k-anderson/irrigation-wireless-relay/rx/rx-back.png

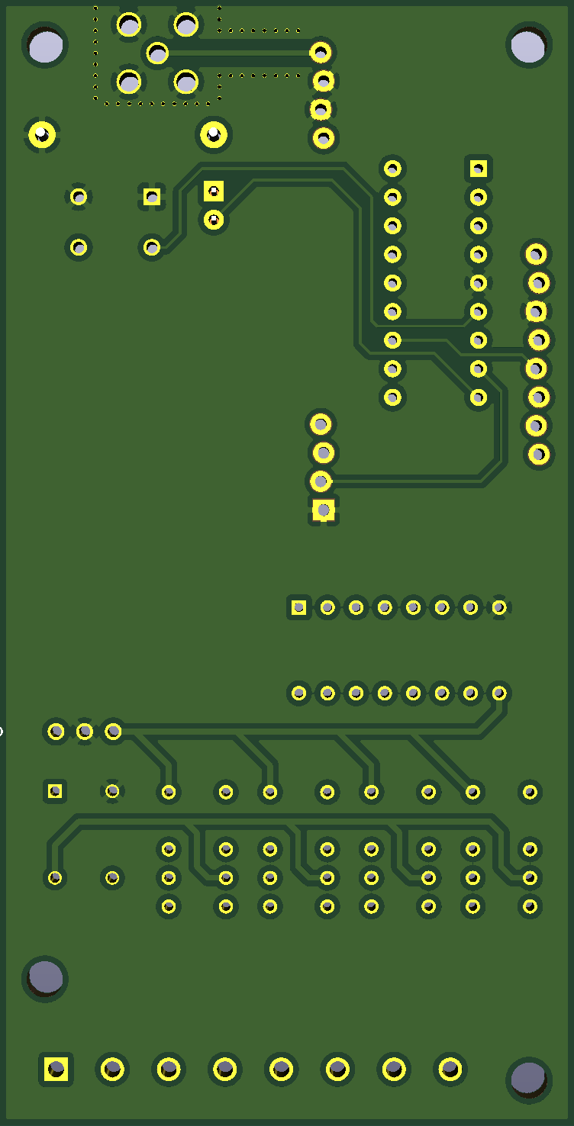
rx/rx-back.png
