k-anderson/irrigation-wireless-relay/rx/rx-front.png

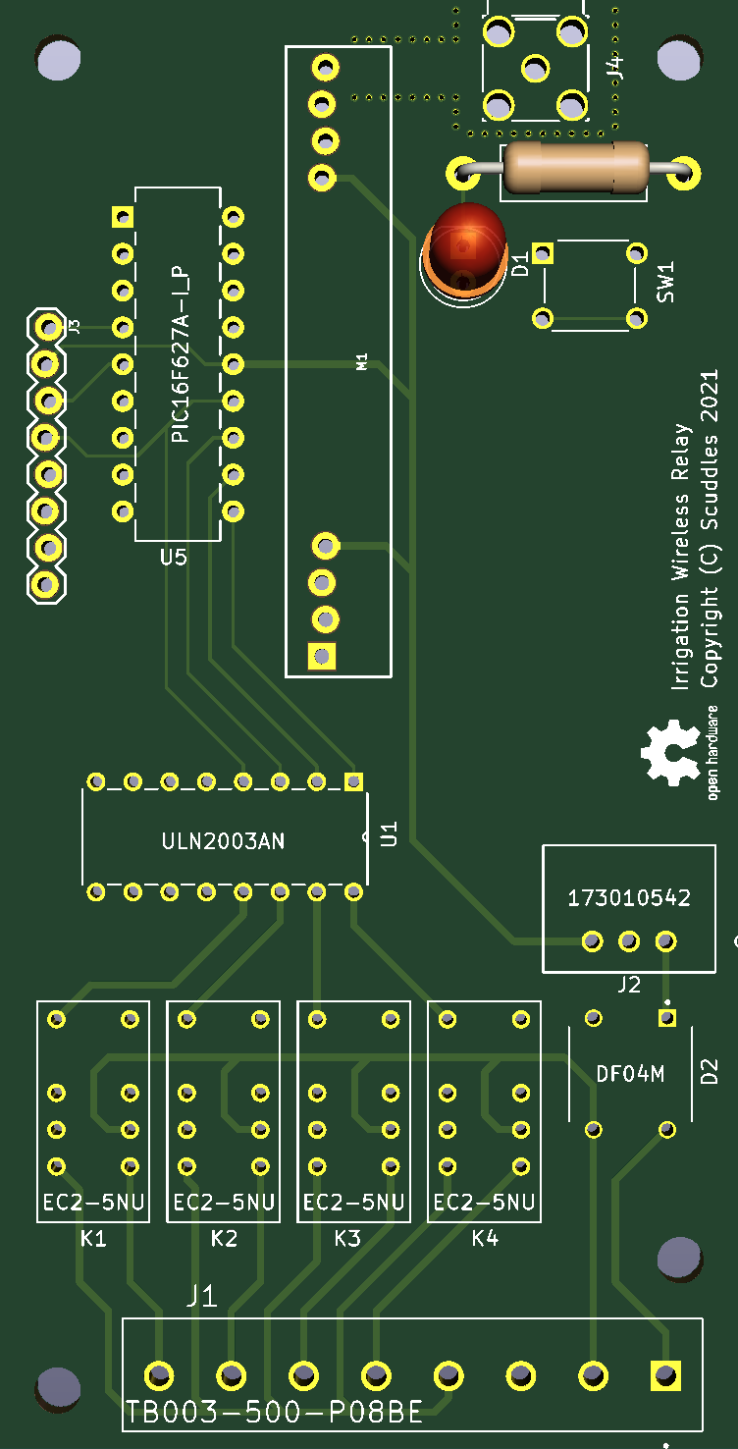
rx/rx-front.png
