k-anderson/irrigation-wireless-relay/rx/rx-prototype.jpg

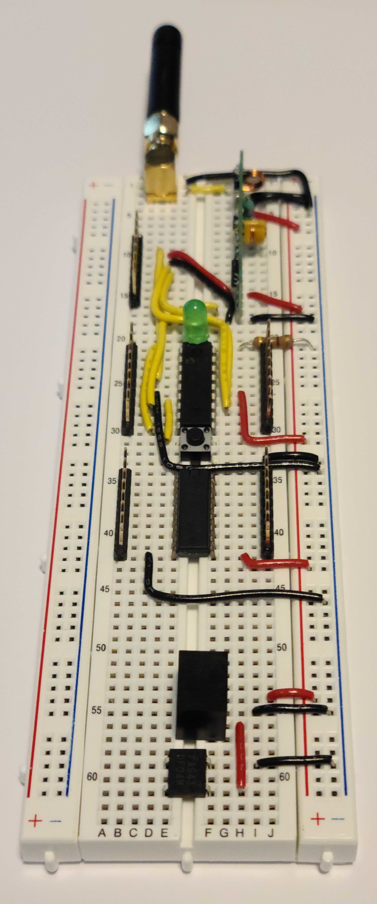
rx/rx-prototype.jpg
