k-anderson/irrigation-wireless-relay/tx/tx-back.png

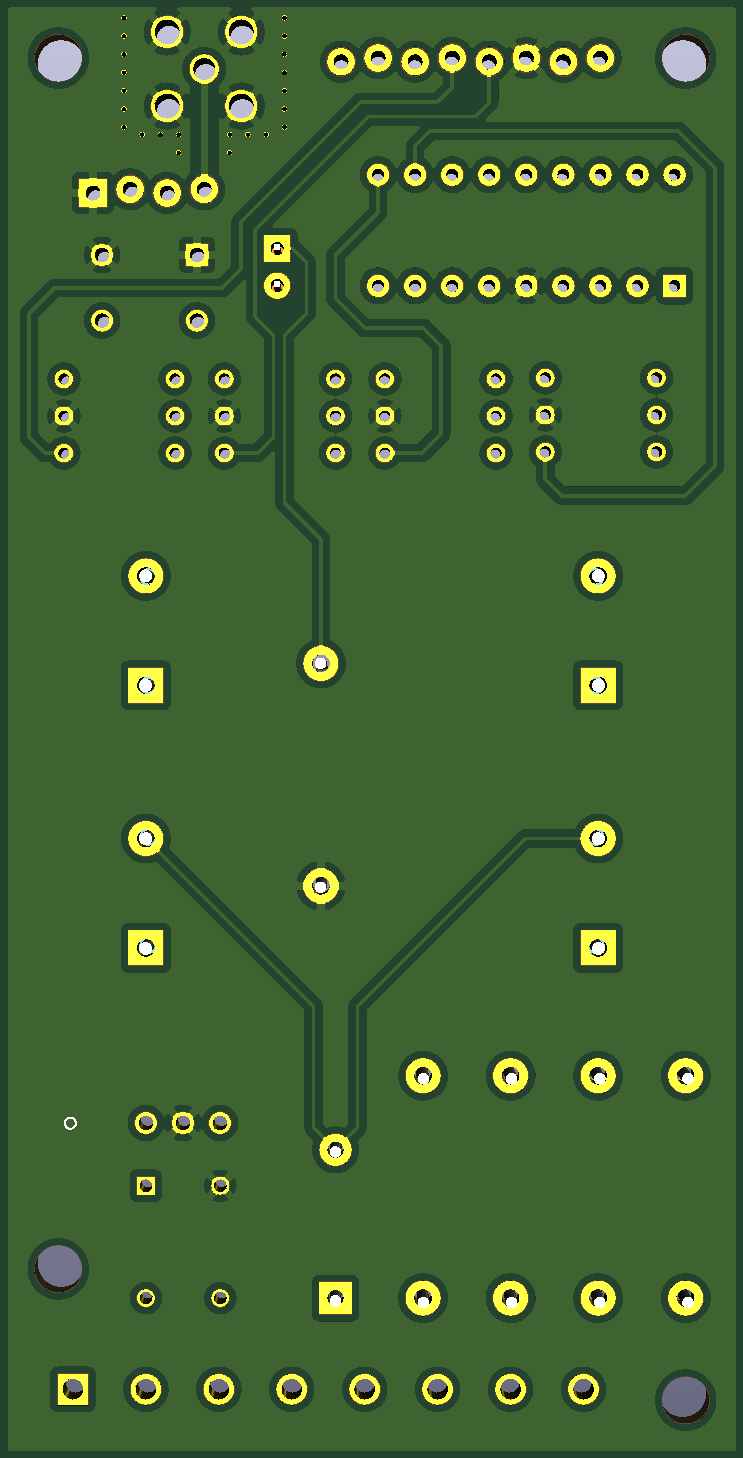
tx/tx-back.png
