k-anderson/irrigation-wireless-relay/tx/tx-front.png

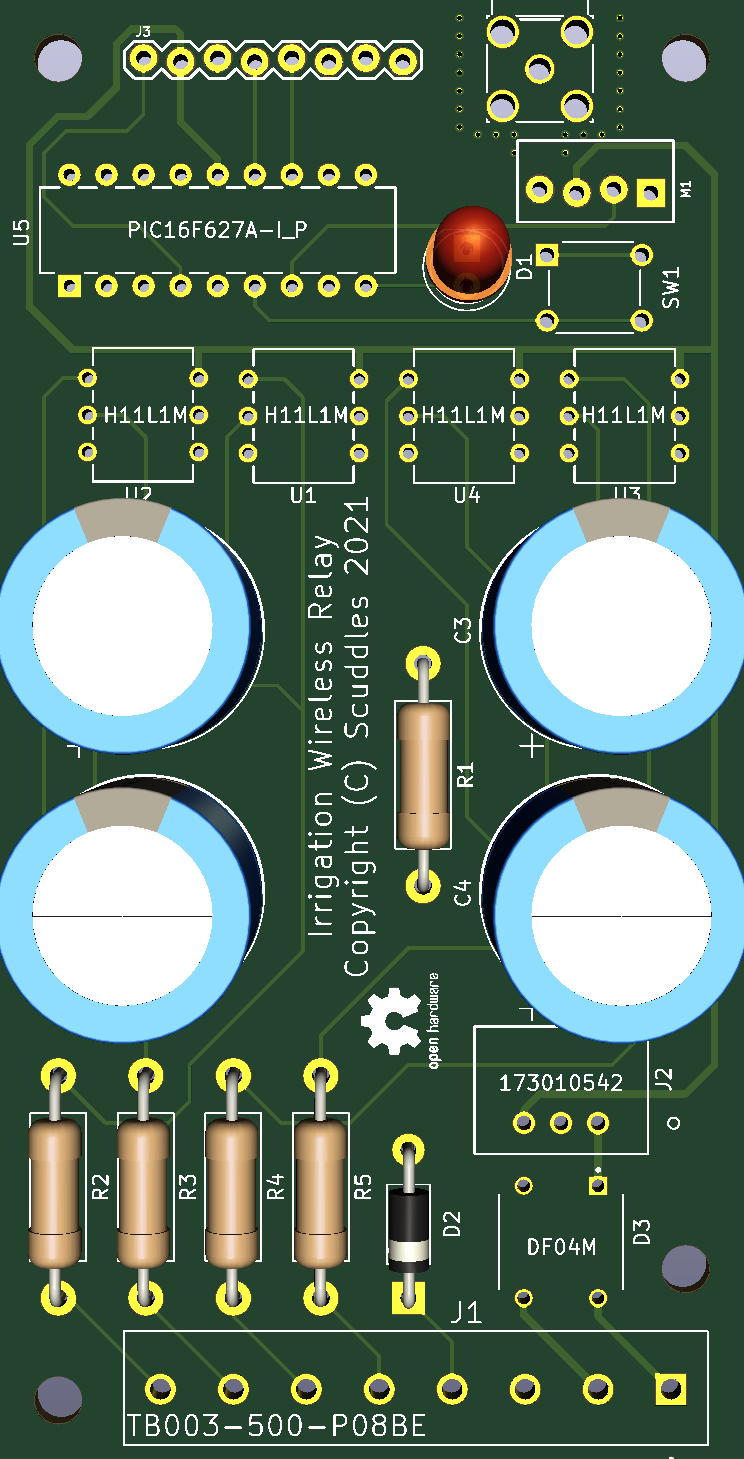
tx/tx-front.png
