k-anderson/irrigation-wireless-relay/tx/tx-prototype.jpg

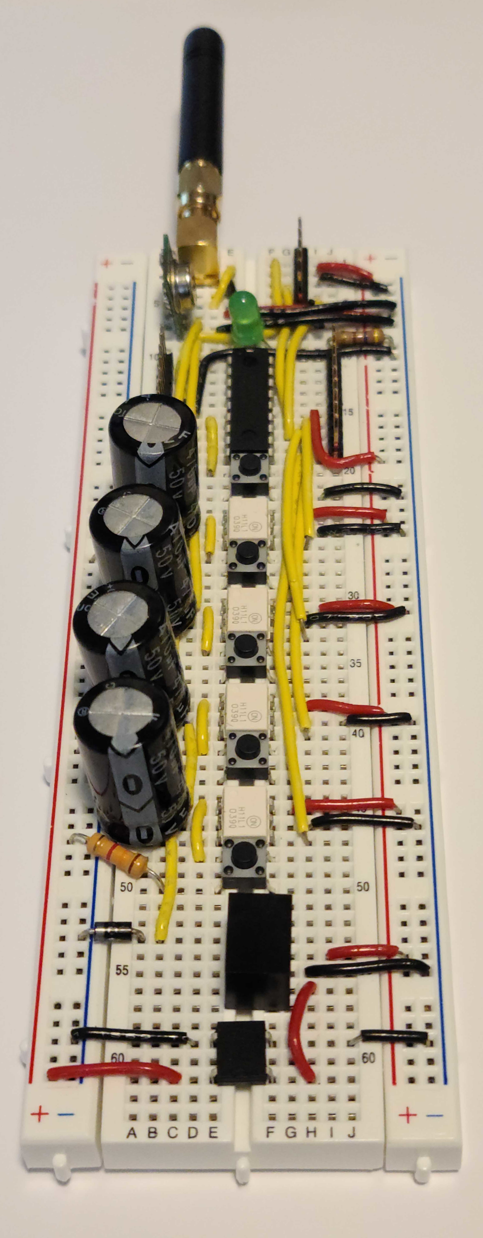
tx/tx-prototype.jpg
