k-anderson/irrigation-wireless-relay/tx/kicad/tx.kicad_pcb

## KiCad design tx/kicad/tx.kicad_pcb (2021-01-27)

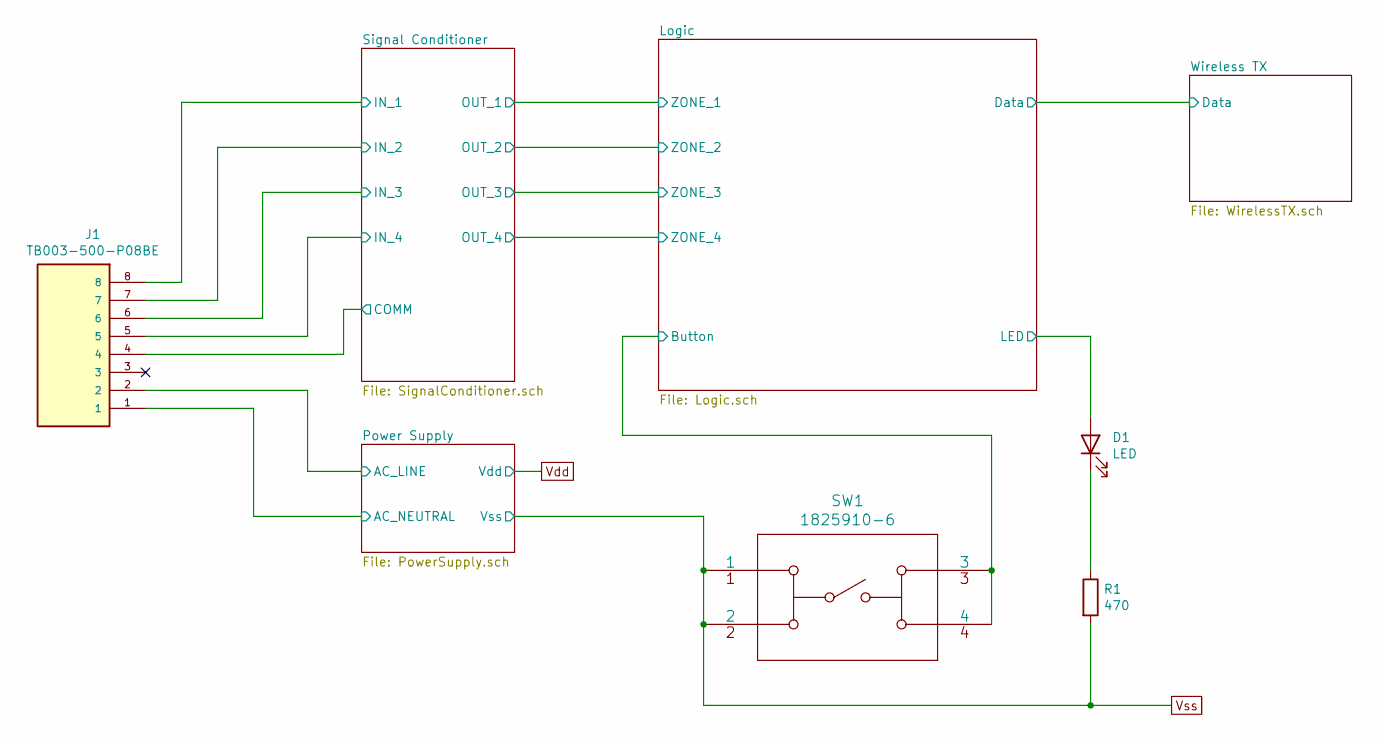
[picture p11: schematic tx.sch]

Parts:
D1: LED; LED_D5.0mm
J1: TB003-500-P08BE; CUI_TB003-500-P08BE
R1: 470; R_Axial_DIN0411_L9.9mm_D3.6mm_P15.24mm_Horizontal
SW1: 1825910-6; Digi-Key_PN 450-1650-ND

Connections:
/Logic/Button: SW1.3, SW1.4; also elsewhere on the board
/Logic/LED: D1.2 (A); also elsewhere on the board
/Power Supply/AC_LINE: J1.2; also elsewhere on the board
/Power Supply/AC_NEUTRAL: J1.1; also elsewhere on the board
/Signal Conditioner/COMM: J1.4; also elsewhere on the board
/Signal Conditioner/IN_1: J1.8; also elsewhere on the board
/Signal Conditioner/IN_2: J1.7; also elsewhere on the board
/Signal Conditioner/IN_3: J1.6; also elsewhere on the board
/Signal Conditioner/IN_4: J1.5; also elsewhere on the board
unnamed: D1.1 (K), R1.1
Vss: R1.2, SW1.1, SW1.2; also elsewhere on the board

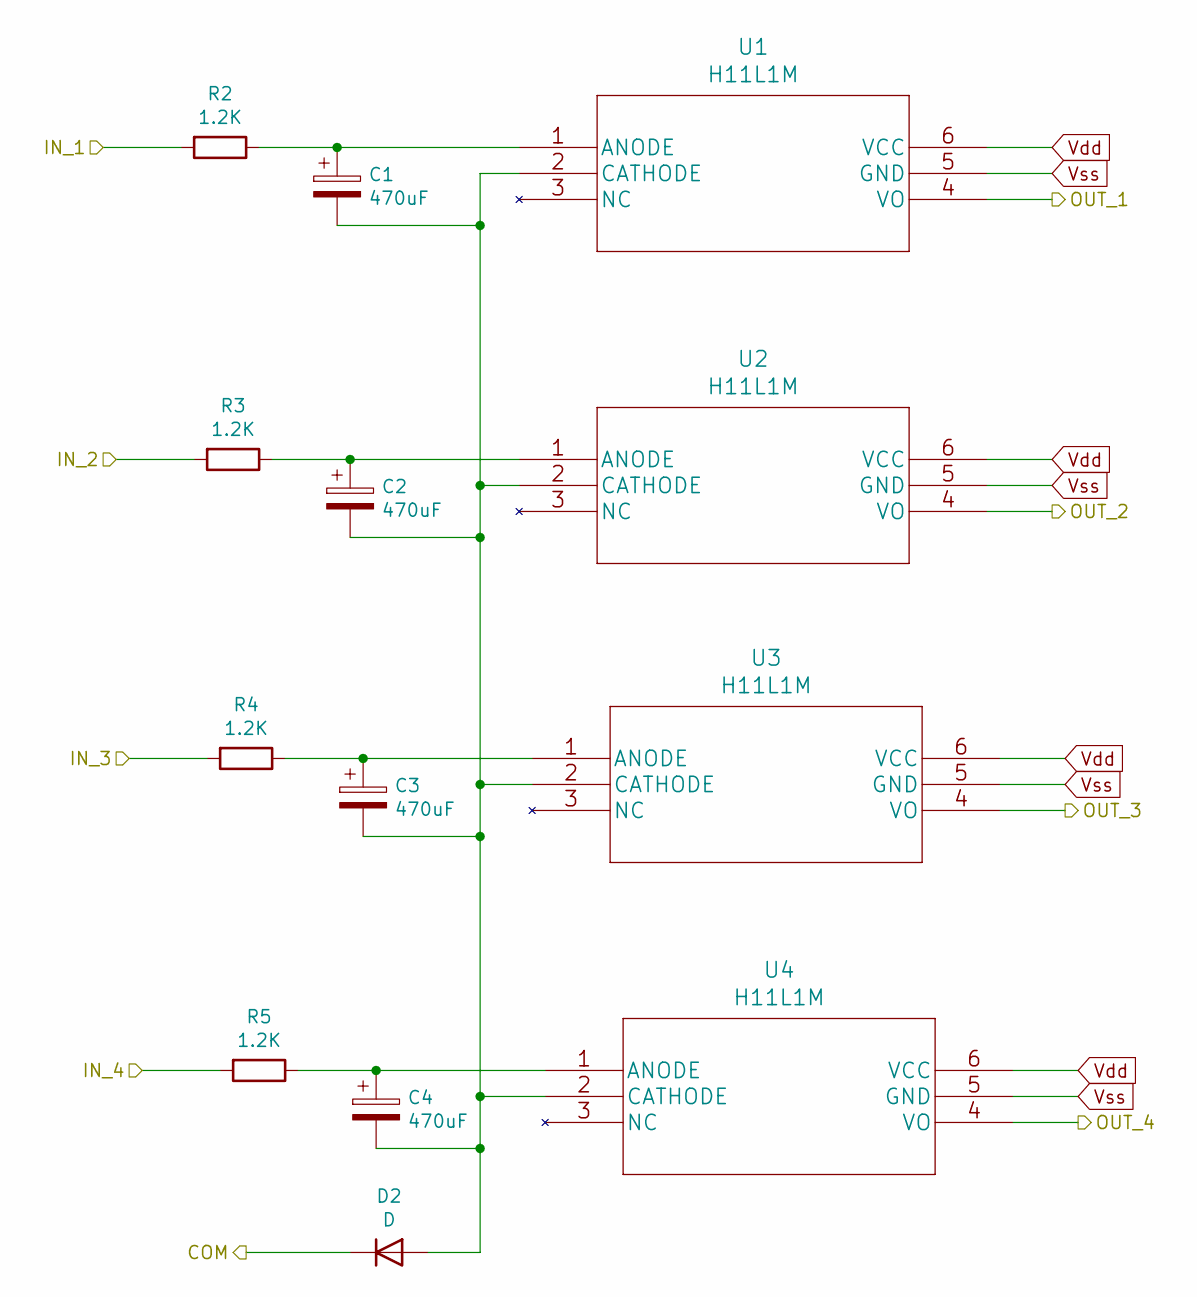
[picture p12: schematic SignalConditioner.sch]

Parts:
C1, C2, C3, C4: 470uF; CP_Radial_D16.0mm_P7.50mm
D2: D; D_DO-41_SOD81_P10.16mm_Horizontal
R2, R3, R4, R5: 1.2K; R_Axial_DIN0411_L9.9mm_D3.6mm_P15.24mm_Horizontal
U1, U2, U3, U4: H11L1M; Digi-Key_PN H11L1-MQT-ND

Connections:
/Signal Conditioner/COMM: D2.1 (K); also elsewhere on the board
/Signal Conditioner/IN_1: R2.2; also elsewhere on the board
/Signal Conditioner/IN_2: R3.2; also elsewhere on the board
/Signal Conditioner/IN_3: R4.2; also elsewhere on the board
/Signal Conditioner/IN_4: R5.2; also elsewhere on the board
/Signal Conditioner/OUT_1: U1.4 (VO); also elsewhere on the board
/Signal Conditioner/OUT_2: U2.4 (VO); also elsewhere on the board
/Signal Conditioner/OUT_3: U3.4 (VO); also elsewhere on the board
/Signal Conditioner/OUT_4: U4.4 (VO); also elsewhere on the board
unnamed: C1.1, R2.1, U1.1 (ANODE)
unnamed: C1.2, C2.2, C3.2, C4.2, D2.2 (A), U1.2 (CATHODE), U2.2 (CATHODE), U3.2 (CATHODE), U4.2 (CATHODE)
unnamed: C2.1, R3.1, U2.1 (ANODE)
unnamed: C3.1, R4.1, U3.1 (ANODE)
unnamed: C4.1, R5.1, U4.1 (ANODE)
Vdd: U1.6 (VCC), U2.6 (VCC), U3.6 (VCC), U4.6 (VCC); also elsewhere on the board
Vss: U1.5 (GND), U2.5 (GND), U3.5 (GND), U4.5 (GND); also elsewhere on the board

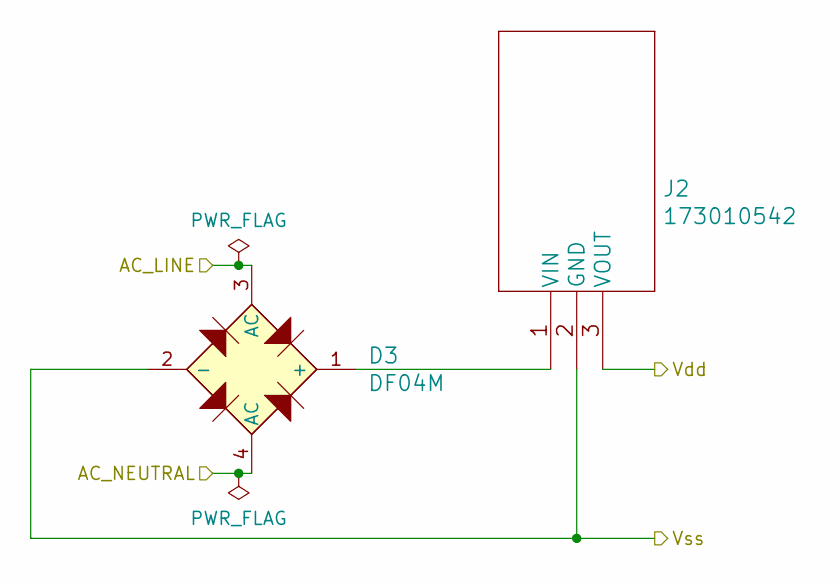
[picture p13: schematic PowerSupply.sch]

Parts:
D3: DF04M; Digi-Key_PN DF04M-ND
J2: 173010542; Digi-Key_PN 732-10874-ND

Connections:
/Power Supply/AC_LINE: D3.3 (AC); also elsewhere on the board
/Power Supply/AC_NEUTRAL: D3.4 (AC); also elsewhere on the board
unnamed: D3.1 (+), J2.1 (VIN)
Vdd: J2.3 (VOUT); also elsewhere on the board
Vss: D3.2 (-), J2.2 (GND); also elsewhere on the board

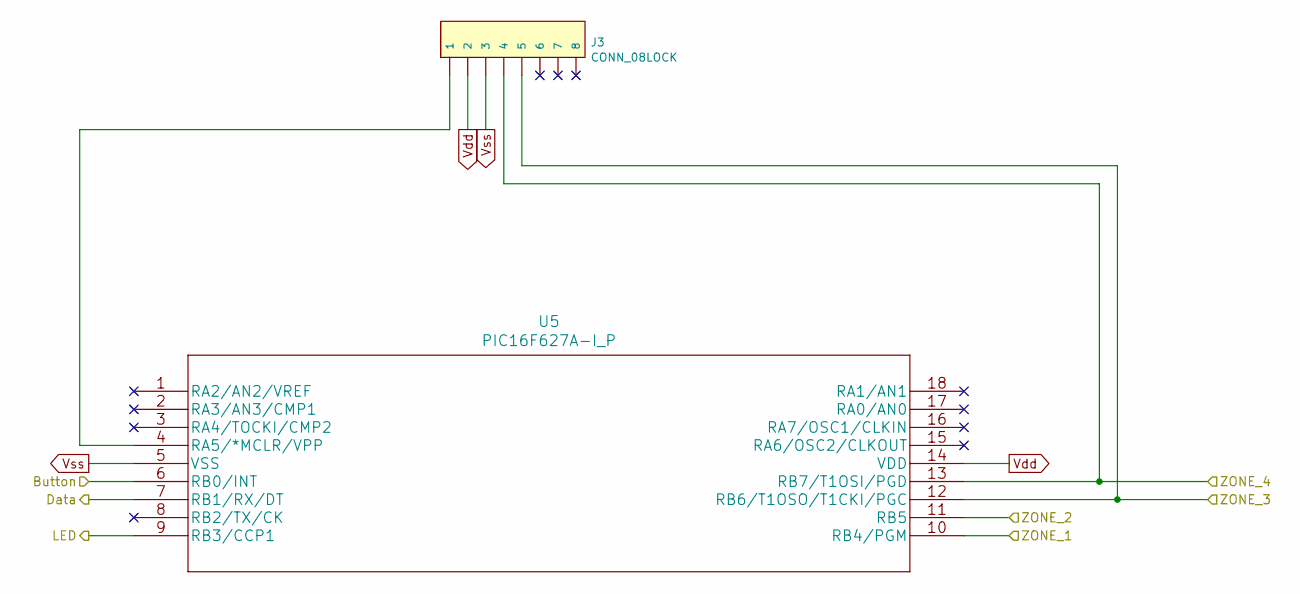
[picture p14: schematic Logic.sch]

Parts:
J3: CONN_08LOCK; 1X08_LOCK
U5: PIC16F627A-I_P; PIC16F627A-I&slash_P; Digi-Key_PN PIC16F627A-I/P-ND

Connections:
/Logic/Button: U5.6 (RB0/INT); also elsewhere on the board
/Logic/Data: U5.7 (RB1/RX/DT); also elsewhere on the board
/Logic/LED: U5.9 (RB3/CCP1); also elsewhere on the board
/Signal Conditioner/OUT_1: U5.10 (RB4/PGM); also elsewhere on the board
/Signal Conditioner/OUT_2: U5.11 (RB5); also elsewhere on the board
/Signal Conditioner/OUT_3: J3.5, U5.12 (RB6/T1OSO/T1CKI/PGC); also elsewhere on the board
/Signal Conditioner/OUT_4: J3.4, U5.13 (RB7/T1OSI/PGD); also elsewhere on the board
unnamed: J3.1, U5.4 (RA5/*MCLR/VPP)
Vdd: J3.2, U5.14 (VDD); also elsewhere on the board
Vss: J3.3, U5.5 (VSS); also elsewhere on the board

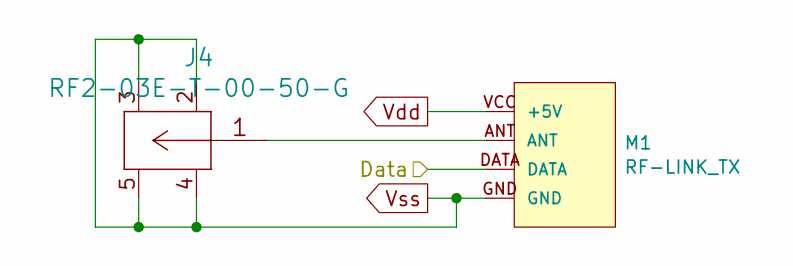
[picture p15: schematic WirelessTX.sch]

Parts:
J4: RF2-03E-T-00-50-G; Digi-Key_PN 2057-RF2-03E-T-00-50-G-ND
M1: RF-LINK_TX; WRL-10534; Digi-Key_PN 1568-1175-ND

Connections:
/Logic/Data: M1.DATA; also elsewhere on the board
unnamed: J4.1, M1.ANT
Vdd: M1.VCC (+5V); also elsewhere on the board
Vss: J4.2 (Shield), J4.3 (Shield), J4.4 (Shield), J4.5 (Shield), M1.GND; also elsewhere on the board

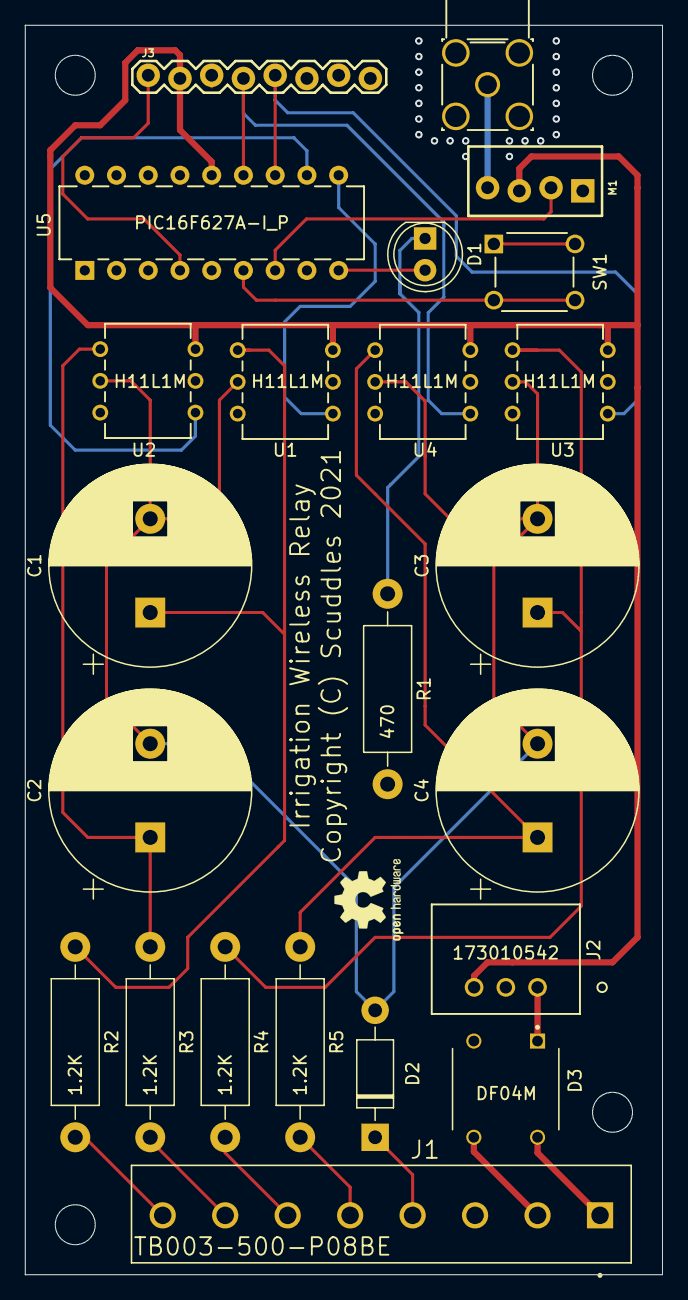
[picture p16: board tx.kicad_pcb from above]

Board: 2 copper layers, 51.0 x 100.0 mm, 23 parts (0 on the bottom side), 25 nets.
