k-anderson/irrigation-wireless-relay/rx/kicad/rx.kicad_pcb

## KiCad design rx/kicad/rx.kicad_pcb (2021-01-27)

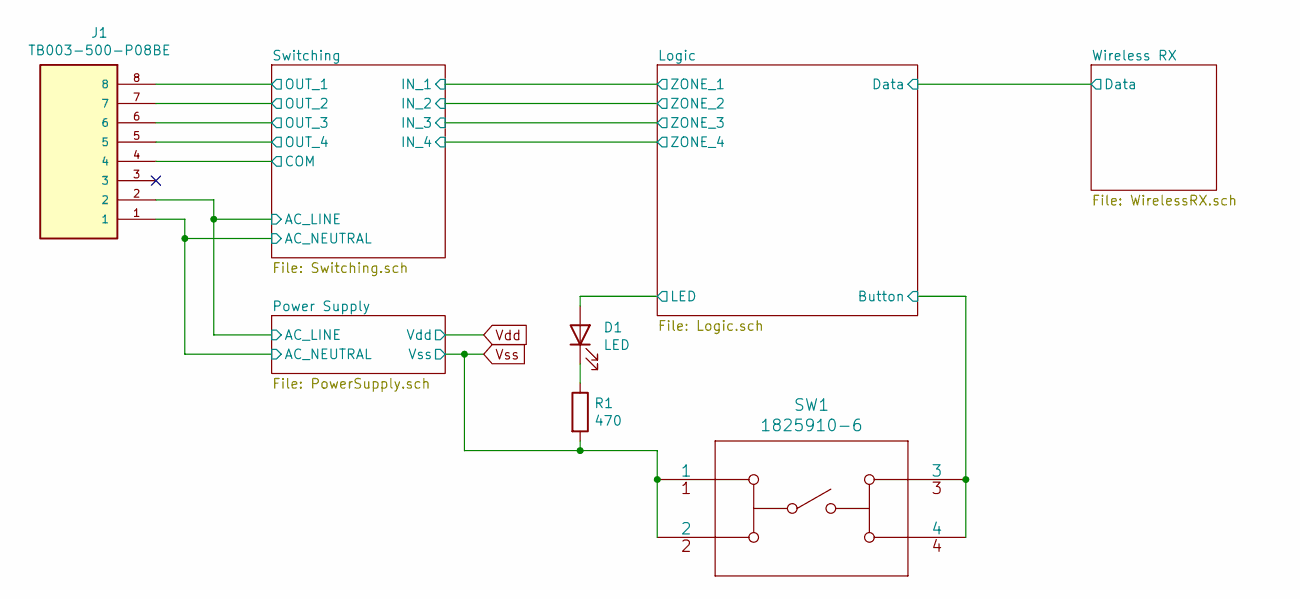
[picture p17: schematic rx.sch]

Parts:
D1: LED; LED_D5.0mm
J1: TB003-500-P08BE; CUI_TB003-500-P08BE
R1: 470; R_Axial_DIN0411_L9.9mm_D3.6mm_P15.24mm_Horizontal
SW1: 1825910-6

Connections:
/Logic/Button: SW1.3, SW1.4; also elsewhere on the board
/Logic/LED: D1.2 (A); also elsewhere on the board
/Power Supply/AC_LINE: J1.2; also elsewhere on the board
/Power Supply/AC_NEUTRAL: J1.1; also elsewhere on the board
/Switching/COM: J1.4; also elsewhere on the board
/Switching/OUT_1: J1.8; also elsewhere on the board
/Switching/OUT_2: J1.7; also elsewhere on the board
/Switching/OUT_3: J1.6; also elsewhere on the board
/Switching/OUT_4: J1.5; also elsewhere on the board
unnamed: D1.1 (K), R1.1
Vss: R1.2, SW1.1, SW1.2; also elsewhere on the board

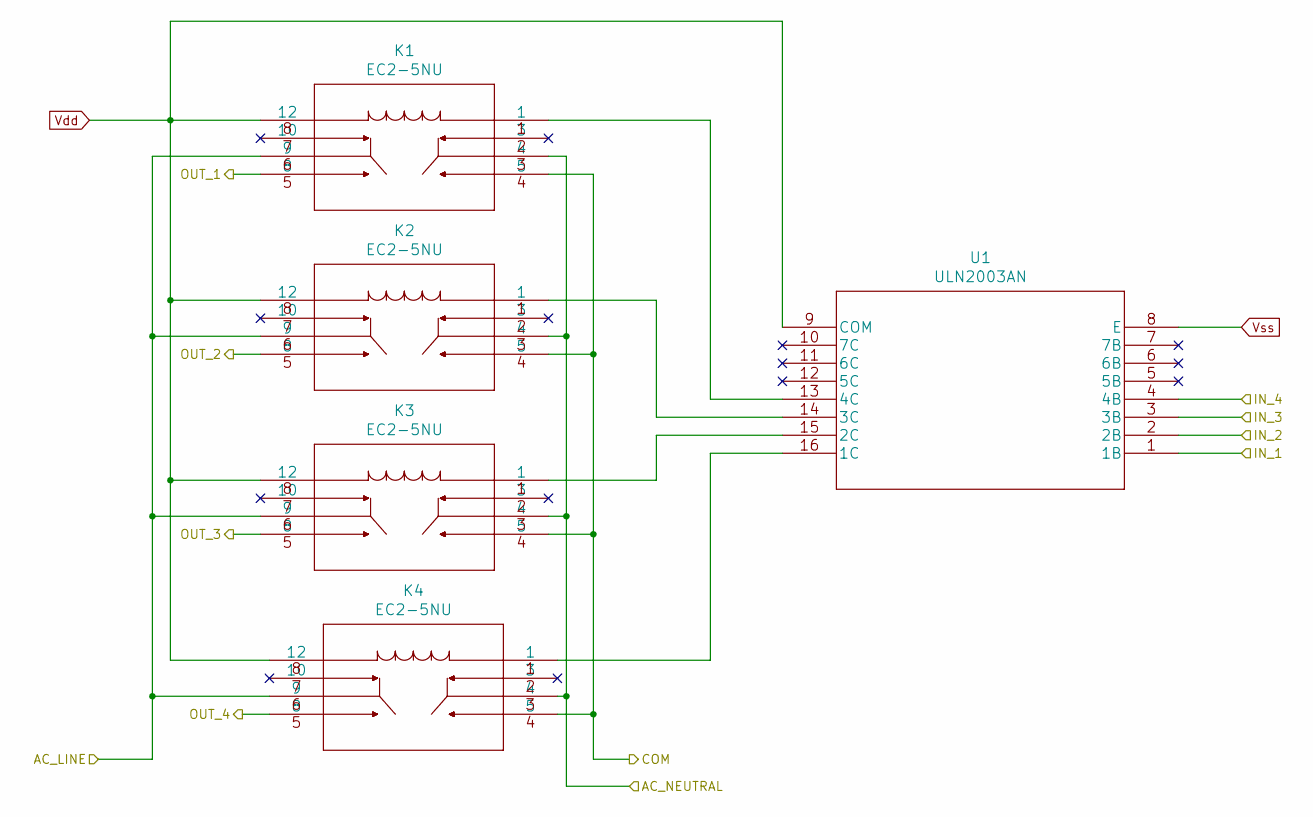
[picture p18: schematic Switching.sch]

Parts:
K1, K2, K3, K4: EC2-5NU
U1: ULN2003AN

Connections:
/Power Supply/AC_LINE: K1.6 (9), K2.6 (9), K3.6 (9), K4.6 (9); also elsewhere on the board
/Power Supply/AC_NEUTRAL: K1.3 (4), K2.3 (4), K3.3 (4), K4.3 (4); also elsewhere on the board
/Switching/COM: K1.4 (5), K2.4 (5), K3.4 (5), K4.4 (5); also elsewhere on the board
/Switching/IN_1: U1.1 (1B); also elsewhere on the board
/Switching/IN_2: U1.2 (2B); also elsewhere on the board
/Switching/IN_3: U1.3 (3B); also elsewhere on the board
/Switching/IN_4: U1.4 (4B); also elsewhere on the board
/Switching/OUT_1: K1.5 (8); also elsewhere on the board
/Switching/OUT_2: K2.5 (8); also elsewhere on the board
/Switching/OUT_3: K3.5 (8); also elsewhere on the board
/Switching/OUT_4: K4.5 (8); also elsewhere on the board
unnamed: K1.1, U1.13 (4C)
unnamed: K2.1, U1.14 (3C)
unnamed: K3.1, U1.15 (2C)
unnamed: K4.1, U1.16 (1C)
Vdd: K1.8 (12), K2.8 (12), K3.8 (12), K4.8 (12), U1.9 (COM); also elsewhere on the board
Vss: U1.8 (E); also elsewhere on the board

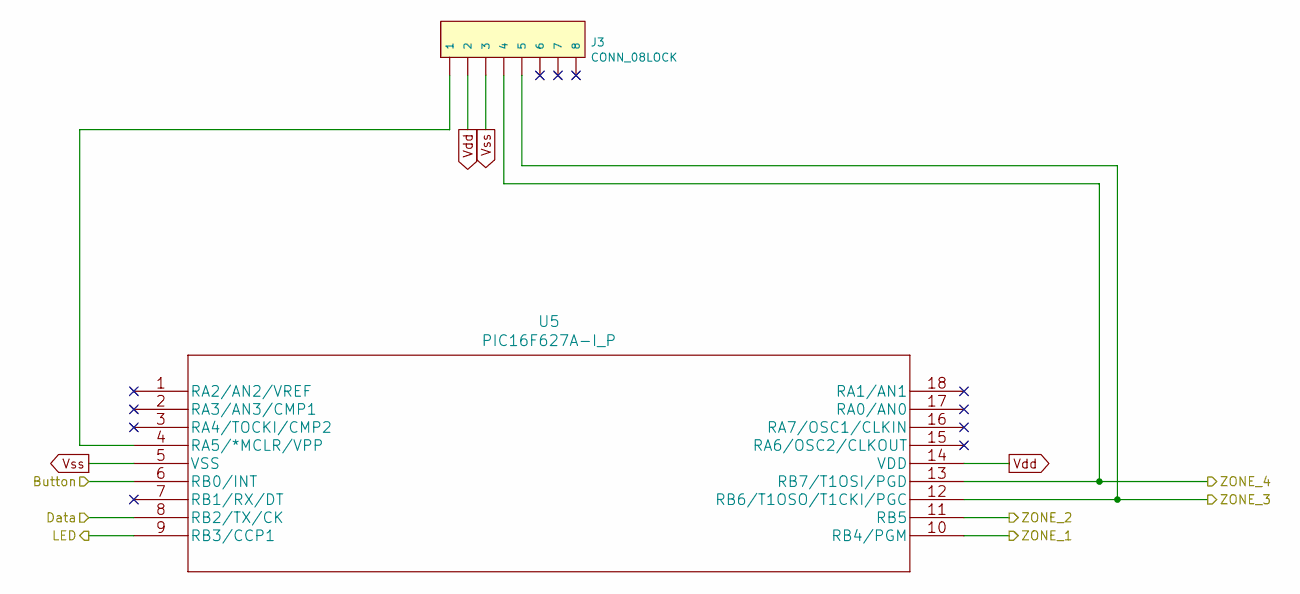
[picture p19: schematic Logic.sch]

Parts:
J3: CONN_08LOCK; 1X08_LOCK
U5: PIC16F627A-I_P; PIC16F627A-I&slash_P; Digi-Key_PN PIC16F627A-I/P-ND

Connections:
/Logic/Button: U5.6 (RB0/INT); also elsewhere on the board
/Logic/Data: U5.8 (RB2/TX/CK); also elsewhere on the board
/Logic/LED: U5.9 (RB3/CCP1); also elsewhere on the board
/Switching/IN_1: U5.10 (RB4/PGM); also elsewhere on the board
/Switching/IN_2: U5.11 (RB5); also elsewhere on the board
/Switching/IN_3: J3.5, U5.12 (RB6/T1OSO/T1CKI/PGC); also elsewhere on the board
/Switching/IN_4: J3.4, U5.13 (RB7/T1OSI/PGD); also elsewhere on the board
unnamed: J3.1, U5.4 (RA5/*MCLR/VPP)
Vdd: J3.2, U5.14 (VDD); also elsewhere on the board
Vss: J3.3, U5.5 (VSS); also elsewhere on the board

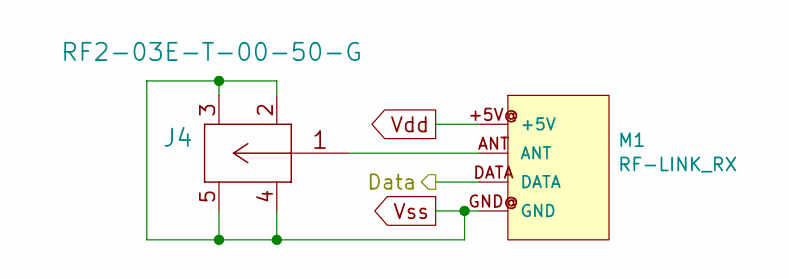
[picture p20: schematic WirelessRX.sch]

Parts:
J4: RF2-03E-T-00-50-G
M1: RF-LINK_RX

Connections:
/Logic/Data: M1.DATA; also elsewhere on the board
unnamed: J4.1, M1.ANT
Vdd: M1.+5V@ (+5V); also elsewhere on the board
Vss: J4.2 (Shield), J4.3 (Shield), J4.4 (Shield), J4.5 (Shield), M1.GND@ (GND); also elsewhere on the board

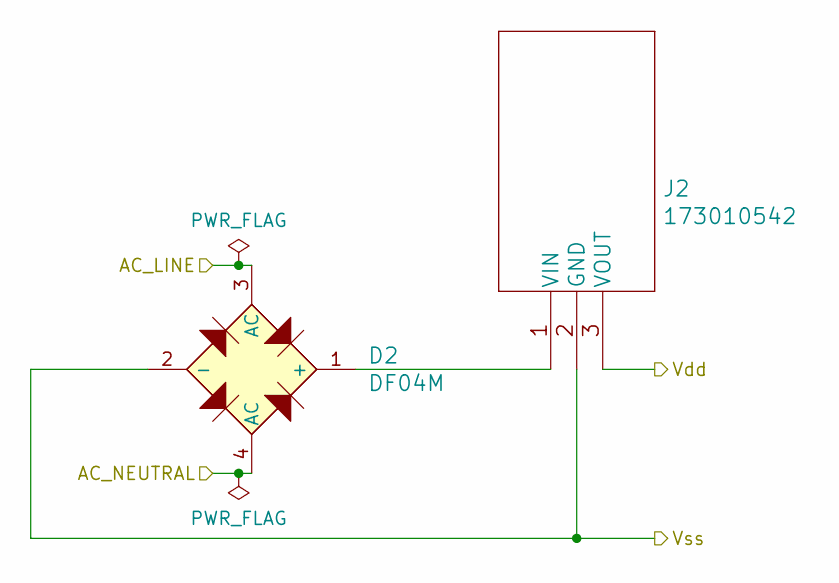
[picture p21: schematic PowerSupply.sch]

Parts:
D2: DF04M; Digi-Key_PN DF04M-ND
J2: 173010542; Digi-Key_PN 732-10874-ND

Connections:
/Power Supply/AC_LINE: D2.3 (AC); also elsewhere on the board
/Power Supply/AC_NEUTRAL: D2.4 (AC); also elsewhere on the board
unnamed: D2.1 (+), J2.1 (VIN)
Vdd: J2.3 (VOUT); also elsewhere on the board
Vss: D2.2 (-), J2.2 (GND); also elsewhere on the board

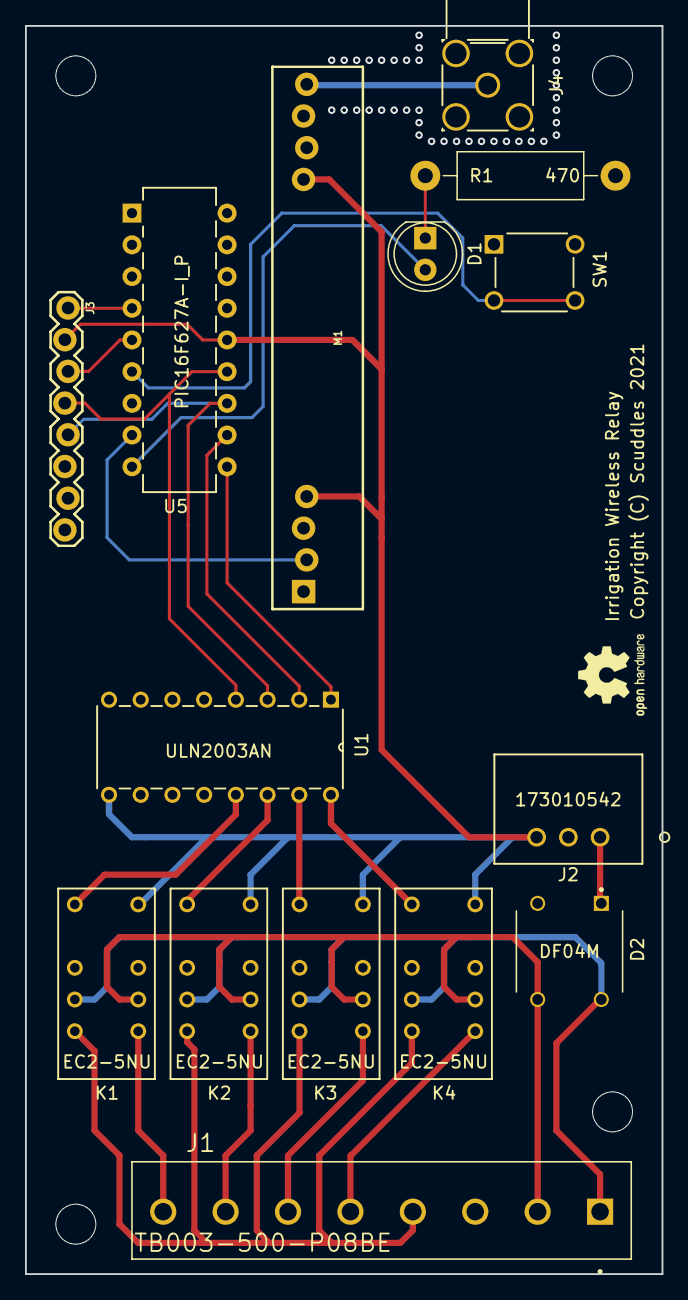
[picture p22: board rx.kicad_pcb from above]

Board: 2 copper layers, 51.0 x 100.0 mm, 15 parts (0 on the bottom side), 24 nets.
