k-anderson/irrigation-wireless-relay/(commit log)

2021-01-27 preparing plots
    [Switching.sch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]
2021-01-31 update prototype pics
