k-anderson/irrigation-wireless-relay/(notices)

Notices in the files:
rx/kicad/rx.kicad_pcb:
Copyright (C) Scuddles 2021
parts and their libraries:
Copyright 2016 Accelerated Designs. All rights reserved.
